17acres/LEDCeilingLight/Schematic and PCB image.PDF

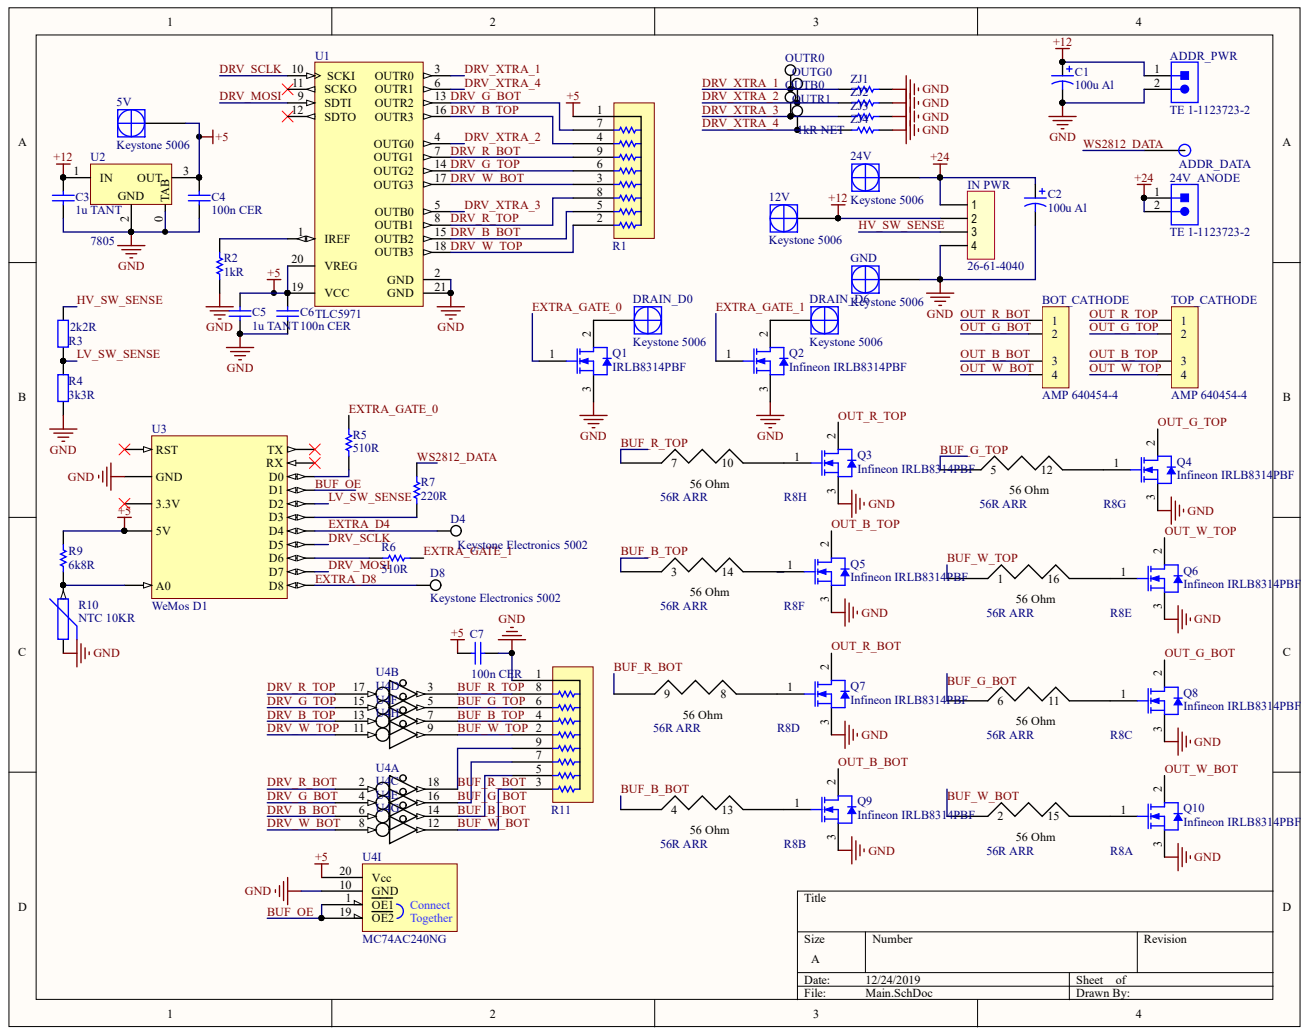
[picture p1: page 1]

IREF 1 | | 7

DRV_XTRA_2 | 4

BUF_R_BOT | 3
BUF_G_BOT

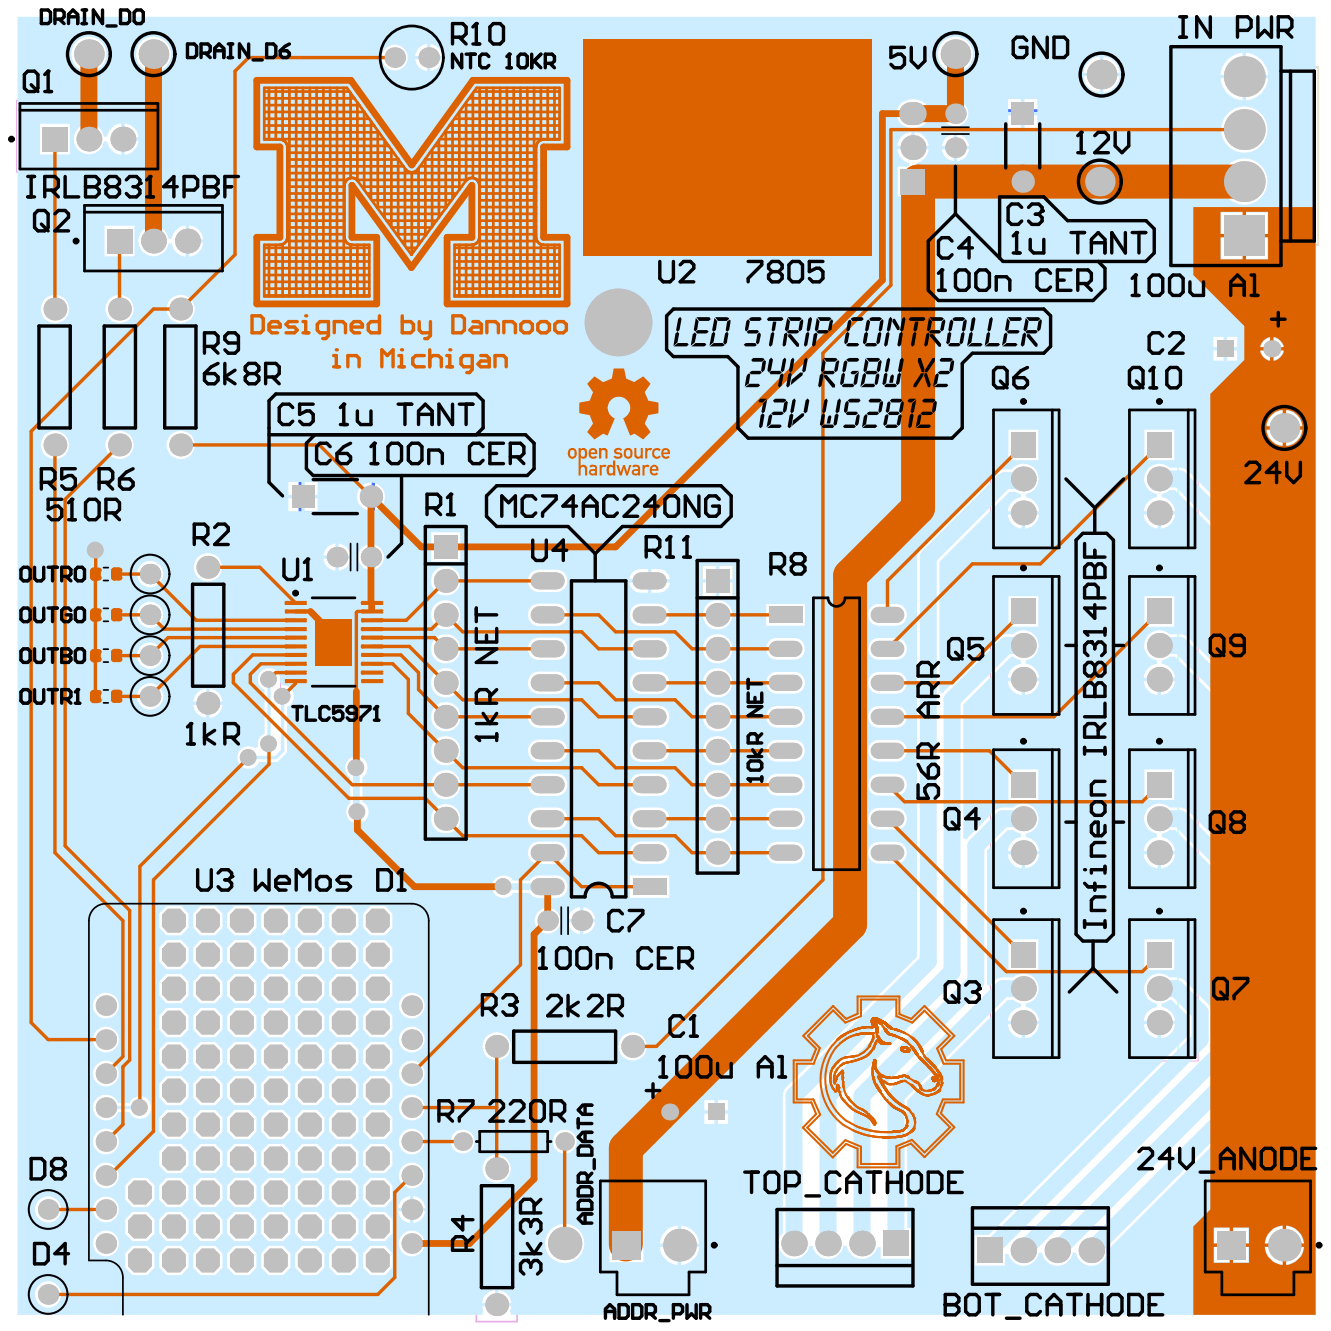
[picture p2: page 2]
