17acres/LEDCeilingLight/(commit log)

2019-08-11 more stuff that doesn't work
    [CeilingLight.ino, addrLeds.hpp, hvLeds.cpp, utils.hpp]
2019-08-15 light switch
2019-09-17 Fix some flicker issues, slow on always resetting?
    [hvLeds.cpp, hvLeds.hpp, webServer.hpp]
2019-09-20 Maybe fix slow on to on transition, email mode ids
    [lightSwitch.hpp, webServer.hpp]
2019-11-24 fix dst issues, update to latest version of esp8266 core
    [emailSender.cpp, timeManager.hpp, webServer.hpp]
2019-12-24 Create Schematic and PCB image.PDF
2019-12-29 try to stop crashing
    [CeilingLight.ino, addrLeds.hpp, utils.hpp]
2020-01-02 hopefully fixing crashing issues using dma
    [CeilingLight.ino, addrLeds.hpp, defs.hpp, hvLeds.cpp, lightSwitch.hpp, utils.hpp]
2020-04-13 Recover after power up, use ESP_EEPROM
2020-06-25 Update for better Google Home integration, remove workaround for NTP
    [timeManager.hpp, webServer.hpp]
2020-12-31 Use AsyncPing lib to try to reboot when connection to network is lost. Might work maybe not
    [webServer.cpp, webServer.hpp]
2021-01-29 Switch to HTTP->TCP relay for remote connection, add spam protection
2021-05-26 Switch to Beebotte MQTT relay for out-of-home communication
2021-07-05 Don't fail if WiFi or internet is lost. Reconnect to MQTT with exponential backoff retries.
    [CeilingLight.ino, emailSender.cpp, timeManager.hpp, utils.hpp, webServer.cpp, webServer.hpp]
